rickelmedias/1-DOF-Copter-Control/report/main.tex

% !TEX program = xelatex
% Modelo reduzido TEECII, Manual MSGQ-21.01 REV.16.

\documentclass[
    12pt,                % Tamanho da fonte base (corpo do texto)
    fleqn,               % Equações alinhadas à esquerda, com numeração à direita
    oneside,            % Impressão apenas em recto (frente das páginas)
    a4paper,            % Tamanho do papel: A4 (21.00 cm × 29.70 cm)
    chapter=TITLE,        % Títulos de capítulos convertidos em MAIÚSCULAS
    section=TITLE,        % Títulos de seções convertidos em MAIÚSCULAS  
    sumario=tradicional,% Estilo do sumário (tradicional = indentado)
    english,            % Idioma adicional para hifenização de termos técnicos
    brazil                % Idioma principal do documento (último da lista)
]{abntex2}
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
\titulo{Controle em tempo real de uma plataforma de estabilização ativa por empuxo}
\subtitulo{} 
\integranteum{Gustavo Aguiar Brandão}\raum{210349}
\integrantedois{Lucas Carvalho}\radois{180352}
\integrantetres{Rickelme Dias}\ratres{224276}
\integrantequatro{Guilherme Cambi Magarotti}\raquatro{222292}
\integrantecinco{Guilherme Felipe Reis Soares}\racinco{211590}
\local{SOROCABA, SP}            
\data{2026}                     

\orientador{Prof. Marcos F. Jardini\\Prof. Adilson Rocha}
\coorientador{}                 

\preambulo{Trabalho de Tópicos Especiais em Engenharia da Computação II apresentado ao Centro Universitário Facens como exigência parcial para aprovação na disciplina do curso de graduação em Engenharia da Computação. Documento de Projeto RTOS para a disciplina TEECII.}

\definecolor{blue}{RGB}{41,5,195}  

\makeatletter
\hypersetup{
    pdftitle={\@title},         
    pdfauthor={Gustavo Aguiar Brandão; Lucas Carvalho; Rickelme Dias; Guilherme Cambi Magarotti; Guilherme Felipe Reis Soares},       
    pdfsubject={\imprimirpreambulo}, 
    pdfcreator={LaTeX with abnTeX2}, 
    pdfkeywords={abnt}{latex}{abntex}{abntex2}{trabalho acadêmico}, 
    colorlinks=true,            
    linkcolor=black,            
    citecolor=black,            
    filecolor=black,            
    urlcolor=black,             
    bookmarksdepth=4            
}
\makeatother

\makeatletter
\setlength{\@fptop}{5pt}        
\makeatother

\newcommand{\quadroname}{Quadro}
\newcommand{\listofquadrosname}{Lista de quadros}

\newfloat[chapter]{quadro}{loq}{\quadroname}
\newlistof{listofquadros}{loq}{\listofquadrosname}
\newlistentry{quadro}{loq}{0}

\setfloatadjustment{quadro}{\centering}
\counterwithout{quadro}{chapter}
\renewcommand{\theHquadro}{\arabic{quadro}}

\renewcommand{\cftquadroname}{\MakeUppercase{\quadroname}\space} 
\renewcommand*{\cftquadroaftersnum}{.}

\renewcommand{\cftfigurename}{FIGURA\space}
\renewcommand{\cfttablename}{TABELA\space}
\renewcommand{\cfttableaftersnum}{.}
\renewcommand*{\cftfigureaftersnum}{.}

\setfloatlocations{quadro}{hbtp}

\captionnamefont{\normalfont\normalsize}
\captiontitlefont{\normalfont\normalsize}
\captiondelim{ -- }
\captionstyle{\centering}
\captionsetup{font=normalsize,labelfont=normalfont,textfont=normalfont,justification=centering,singlelinecheck=false,labelsep=endash,position=top,skip=8pt}

\makeatletter
\renewcommand{\fonte}[1]{\par%
  \vspace{2pt} % manual: sem espaço entre o elemento e sua fonte
  {\centering\fontsize{10}{12}\selectfont Fonte: #1\par}%
}
\makeatother

\makeatletter
\settocpreprocessor{chapter}{%
    \let\tempf@rtoc\f@rtoc%     
    \def\f@rtoc{%               
      \texorpdfstring{\MakeTextUppercase{%
        \tempf@rtoc}%           
      }{\tempf@rtoc}%           
    }% 
}
\makeatother

\makeatletter
\let\oldcontentsline\contentsline
\def\contentsline#1#2{%
  \expandafter\ifx\csname l@#1\endcsname\l@section
    \expandafter\@firstoftwo      
  \else
    \expandafter\@secondoftwo     
  \fi
  {%
    \oldcontentsline{#1}{\MakeTextUppercase{#2}}%  
  }{%
    \oldcontentsline{#1}{#2}%     
  }%
}
\makeatother

\cftsetindents{chapter}{0cm}{0.5cm}
\cftsetindents{section}{0cm}{0.8cm}
\cftsetindents{subsection}{0cm}{1.1cm}
\cftsetindents{subsubsection}{0cm}{1.45cm}

\usepackage{float}              

\setlength{\parindent}{1.25cm}  
\setlength{\parskip}{0.0cm}     

\newlist{alineastcc}{enumerate}{1}
\setlist[alineastcc]{
    label=\alph*),
    align=left,
    labelindent=1.88cm,
    labelwidth=0.44cm,
    labelsep=0.20cm,
    leftmargin=2.52cm,
    itemindent=0pt,
    listparindent=0pt,
    itemsep=0pt,
    parsep=0pt,
    topsep=0.5\baselineskip
}

\setlength{\afterchapskip}{\baselineskip}
\setlength{\aftersecskip}{\baselineskip}
\setlength{\aftersubsecskip}{\baselineskip}

\makepagestyle{cabecalhopaginaimpar}
  \makeoddhead{cabecalhopaginaimpar}  
    {}                          
    {}                          
    {\fontsize{10}{12}\selectfont\thepage}            

\begin{document}

\selectlanguage{brazil}
\OnehalfSpacing         
\frenchspacing                  

\hypersetup{pageanchor=false}
\imprimircapa                   
\hypersetup{pageanchor=true}
\pretextual
\imprimirfolhaderosto* 

\input{parts/front_matter/resumo.tex}
\input{parts/front_matter/lista_figuras.tex}
\input{parts/front_matter/lista_tabelas.tex}
\input{parts/front_matter/lista_siglas.tex}
\input{parts/front_matter/lista_simbolos.tex}
\clearpage

\input{parts/front_matter/sumario.tex}

\textual                        
\pagestyle{cabecalhopaginaimpar}
\aliaspagestyle{chapter}{cabecalhopaginaimpar}

\input{parts/body/introducao.tex}
\clearpage
\input{parts/body/referencial_teorico.tex}
\clearpage
\input{parts/body/metodologias.tex}
\clearpage

\input{parts/body/resultados.tex}
\clearpage
\input{parts/body/conclusao.tex}
\clearpage

\makeatletter
\renewcommand{\bibsection}{%
    \cleardoublepage
    \phantomsection
    \Hy@raisedlink{\hyper@anchorstart{referencias.titulo}\hyper@anchorend}%
    \def\@currentHref{referencias.titulo}%
    \addcontentsline{toc}{chapter}{REFERÊNCIAS}
    \begin{flushleft}
        \chaptitlefont\MakeTextUppercase{\bibname}
    \end{flushleft}
    \vspace{\afterchapskip}
}
\makeatother
\begin{SingleSpace}
\RaggedRight
\interlinepenalty=10000
\setlength{\bibitemsep}{\baselineskip}
\bibliography{references}       
\end{SingleSpace}

\end{document}
