rickelmedias/1-DOF-Copter-Control/report/images/photos/power_supply.jpg

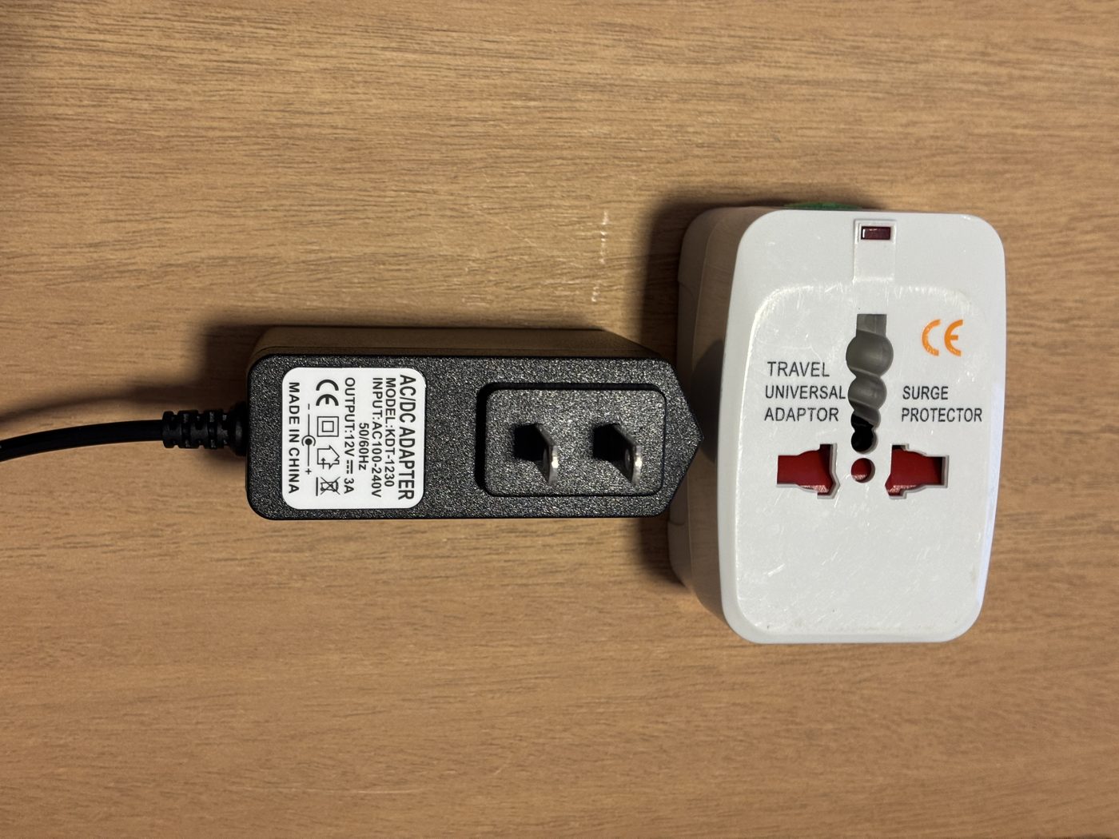
report/images/photos/power_supply.jpg
