rickelmedias/1-DOF-Copter-Control/report/images/prototype/final_rodando.jpg

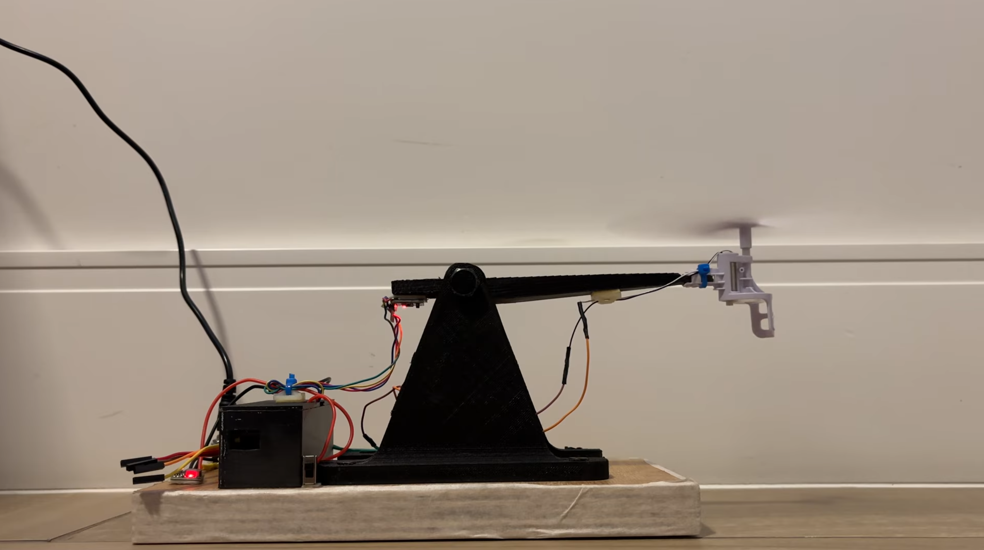
report/images/prototype/final_rodando.jpg
