rickelmedias/1-DOF-Copter-Control/report/parts/front_matter/lista_siglas.tex

\renewcommand{\listadesiglasname}{LISTA DE SIGLAS}
\begin{siglas}
 \item[1-DOF] \textit{One Degree of Freedom} (um grau de liberdade)
 \item[API] \textit{Application Programming Interface}
 \item[BEC] \textit{Battery Eliminator Circuit} (regulador de tensão)
 \item[CMSIS] \textit{Cortex Microcontroller Software Interface Standard}
 \item[DWT] \textit{Data Watchpoint and Trace}
 \item[GPIO] \textit{General-Purpose Input/Output}
 \item[HAL] \textit{Hardware Abstraction Layer}
 \item[I\textsuperscript{2}C] \textit{Inter-Integrated Circuit}
 \item[IAE] \textit{Integral of Absolute Error} (integral do módulo do erro)
 \item[IDE] \textit{Integrated Development Environment}
 \item[IMU] \textit{Inertial Measurement Unit}
 \item[ISR] \textit{Interrupt Service Routine}
 \item[LED] \textit{Light-Emitting Diode}
 \item[MISRA] \textit{Motor Industry Software Reliability Association}
 \item[NVIC] \textit{Nested Vectored Interrupt Controller}
 \item[PID] Proporcional--Integral--Derivativo
 \item[PLL] \textit{Phase-Locked Loop}
 \item[PWM] \textit{Pulse Width Modulation}
 \item[RA] Registro Acadêmico
 \item[RAM] \textit{Random-Access Memory}
 \item[RMS] \textit{Root Mean Square}
 \item[RTOS] \textit{Real-Time Operating System}
 \item[SRAM] \textit{Static Random-Access Memory}
 \item[SWD] \textit{Serial Wire Debug}
 \item[UART] \textit{Universal Asynchronous Receiver-Transmitter}
 \item[USART] \textit{Universal Synchronous/Asynchronous Receiver-Transmitter}
 \item[USB] \textit{Universal Serial Bus}
\end{siglas}
