rickelmedias/1-DOF-Copter-Control/report/parts/front_matter/lista_simbolos.tex

\begin{simbolos}
    \item[$\theta$] Ângulo da haste em relação à horizontal, em graus (radianos nas equações físicas)
    \item[$\hat{\theta}$] Estimativa filtrada do ângulo da haste
    \item[$\dot{\theta}$] Velocidade angular da haste, em graus/s
    \item[$F$] Empuxo produzido pelo conjunto motor--hélice, em N
    \item[$F_{\max}$] Empuxo máximo admitido no modelo, em N
    \item[$u$] Comando PWM normalizado, sem unidade
    \item[$J$] Momento de inércia do conjunto móvel em torno do pivô, em kg m$^2$
    \item[$S_m$] Momento estático das massas em relação ao pivô, em kg m
    \item[$l_m$] Braço do empuxo em relação ao pivô, em m
    \item[$b$] Coeficiente de atrito viscoso da junta, em N m s/rad
    \item[$\tau_m$] Constante de tempo do motor, em s
    \item[$\tau_f$] Constante de tempo do filtro complementar, em s
    \item[$T_s$] Período de amostragem do controle, em s
    \item[$K_p$, $K_i$, $K_d$] Ganhos proporcional, integral e derivativo do controlador PID
    \item[bit/s] Bits por segundo (unidade)
    \item[Hz, kHz, MHz] Hertz, quilohertz e megahertz (unidades)
    \item[kg] Quilograma (unidade)
    \item[ms, $\mu$s] Milissegundo e microssegundo (unidades)
    \item[N] Newton (unidade)
    \item[rad] Radiano (unidade)
    \item[s] Segundo (unidade)
\end{simbolos}
