rickelmedias/1-DOF-Copter-Control/report/parts/front_matter/resumo.tex

\begin{resumo}[RESUMO]
\begin{SingleSpace}
\noindent A malha de atitude de um drone é um sistema de controle crítico, uma vez que atrasos na leitura do sensor, no cálculo ou na atuação podem levar o veículo à queda. Este trabalho reproduz esse problema em uma haste de um grau de liberdade, com motor e hélice em uma extremidade e um sensor inercial na outra, controlada por um microcontrolador STM32F103 com o sistema operacional de tempo real FreeRTOS. A malha de controle é executada em uma tarefa acordada a cada cinco milissegundos por um semáforo liberado pelo temporizador, enquanto os comandos e a telemetria são tratados em tarefas de menor prioridade. Medido no próprio microcontrolador, o atraso entre a interrupção e a atualização do comando do motor foi de no máximo 0,58 milissegundo, pouco mais de um décimo do período, sem nenhum ciclo perdido em quase 35 mil ciclos. Os principais problemas encontrados foram o aquecimento do motor, resolvido com um indutor em série; o ruído do acelerômetro com a hélice em rotação e a deriva do giroscópio, tratados com um filtro complementar que corrige o ângulo lentamente durante o voo; e a oscilação do controlador proporcional-integral-derivativo, tratada com sintonia por margem de fase, proteção contra a saturação do integrador e desligamento do motor por ângulo. Na bancada, a haste pairou com erro quadrático médio inferior a três décimos de grau, e um refino com cinco conjuntos de ganhos reduziu em 28 por cento o erro acumulado na resposta a mudanças de referência.
\par\vspace{2\baselineskip}
\noindent\textbf{Palavras-chave: Controle de posição. Sistemas de tempo real. Modelagem dinâmica. Simulação. Sistemas embarcados.}
\end{SingleSpace}
\end{resumo}
\begin{otherlanguage*}{english}
\begin{resumo}[ABSTRACT]
\begin{SingleSpace}
\noindent The attitude loop of a drone is a safety-critical control system: if sensing, computation or actuation is late, the vehicle falls. This work reproduces that problem on a one-degree-of-freedom rod, with a motor and propeller at one end and an inertial sensor at the other, controlled by an STM32F103 microcontroller running the FreeRTOS real-time operating system. The control loop runs in a task woken every five milliseconds by a semaphore released by the timer, while commands and telemetry run in lower-priority tasks. Measured on the microcontroller itself, the delay from the timer interrupt to the motor command update was at most 0.58 millisecond, slightly more than one tenth of the period, with no lost cycle in almost 35 thousand cycles. The main problems were motor heating, solved with a series inductor; accelerometer noise with the propeller running and gyroscope drift, handled by a complementary filter that corrects the angle slowly in flight; and oscillation of the proportional-integral-derivative controller, handled by phase-margin tuning, protection against integrator saturation and an angle cutoff for the motor. On the bench, the rod hovered with a root-mean-square error below three tenths of a degree, and a refinement with five gain sets reduced the accumulated error in the response to reference changes by 28 percent.
\par\vspace{2\baselineskip}
\noindent\textbf{Keywords: Position control. Real-time systems. Dynamic modeling. Simulation. Embedded systems.}
\end{SingleSpace}
\end{resumo}
\end{otherlanguage*}
