rickelmedias/1-DOF-Copter-Control/report/parts/body/referencial_teorico.tex

\chapter{SISTEMAS CRÍTICOS, RTOS E FREERTOS}\label{cap:rtos}

Este capítulo reúne os fundamentos que sustentam as decisões de projeto. Inicialmente, discute-se por que a malha de estabilização da haste deve ser tratada como um sistema de tempo real; em seguida, apresentam-se os conceitos de sistema operacional de tempo real e os recursos do FreeRTOS empregados no firmware; por fim, resumem-se os fundamentos de estimação de ângulo e de controle PID utilizados nos capítulos seguintes.

\section{POR QUE UM SISTEMA CRÍTICO}

Um sistema de tempo real é aquele cujo comportamento correto depende não apenas do resultado lógico das computações, mas também do instante em que esse resultado é produzido \cite[p.~2]{burns2009}. Segundo \citeonline[p.~2--3]{burns2009}, os sistemas de tempo real classificam-se conforme a consequência da perda de um prazo: nos sistemas \textit{hard}, é absolutamente imperativo que as respostas ocorram dentro do prazo especificado; nos sistemas \textit{soft}, os tempos de resposta são importantes, mas o sistema continua a funcionar corretamente se os prazos forem perdidos ocasionalmente; e um prazo que pode ser perdido ocasionalmente, mas cuja entrega tardia não traz nenhum benefício, é denominado \textit{firm}. Os mesmos autores citam o sistema de controle de voo de uma aeronave de combate como exemplo de sistema \textit{hard}, pois a perda de um prazo pode levar a uma catástrofe \cite[p.~3]{burns2009}.

A malha de atitude de um multirrotor aproxima-se da primeira classe, uma vez que o veículo é instável em malha aberta e uma sequência de atualizações atrasadas permite que o ângulo cresça até a queda. A haste 1-DOF reproduz essa característica. Com o motor desligado, a haste repousa em cerca de $-38^\circ$ (valor lido pelo sensor); nas proximidades da horizontal não há torque restaurador, e a planta comporta-se como um integrador duplo, de modo que o empuxo precisa ser corrigido continuamente. Dois fatos medidos na bancada tornam o prazo concreto: o empuxo responde ao comando com atraso de cerca de 58~ms (Capítulo~\ref{cap:processo}), e a haste acelera cerca de $300^\circ/\mathrm{s}^2$ para cada 1\% de PWM. Assim, uma interrupção do controle por algumas dezenas de milissegundos é suficiente para que a haste percorra uma fração relevante da faixa de operação. O período adotado, de 5~ms, é cerca de doze vezes menor que o atraso do atuador; atrasos sistemáticos nas atualizações reduziriam a margem de fase da malha e a levariam à oscilação.

A política implementada para falhas é deliberadamente simples: uma leitura inválida faz o ciclo ser descartado, mantendo-se a saída anterior; se o sensor permanecer 50~ms sem responder (10 ciclos consecutivos), o motor é desligado. O firmware não descarta amostras por idade; o atraso da malha é tratado na análise temporal (Seção~\ref{sec:temporal}). Segundo a classificação anterior, o enquadramento do sistema como \textit{hard} ou \textit{firm} depende do efeito da perda de um prazo. Neste protótipo, o pior caso é a queda da haste, sem risco para pessoas; por esse motivo, o prazo é tratado como crítico para o desempenho, e não para a segurança.

Controladores de voo reais seguem a mesma lógica. \citeonline[p.~134870]{rico2022} propõem um controlador de voo para aplicações profissionais executado sobre um RTOS simplificado, com escalonador híbrido que combina ordem de chegada (\textit{first-come-first-serve}) e prazo mais próximo primeiro (\textit{earliest deadline first}) com prioridade dinâmica; o sistema é avaliado por testes de escalonabilidade para monoprocessadores e por dados reais de voo, e os sensores redundantes ficam em uma unidade isolada das vibrações da estrutura. O presente trabalho, por sua vez, emprega o escalonamento preemptivo por prioridades fixas do FreeRTOS, suficiente para uma malha crítica e duas tarefas de apoio.

\section{SISTEMAS OPERACIONAIS DE TEMPO REAL}

Um sistema operacional organiza a execução dos programas e o acesso aos recursos do processador. Em um sistema embarcado, cada tarefa é um trecho de código executado como se dispusesse do processador de forma exclusiva; o escalonador decide qual tarefa executa a cada instante, e as interrupções sinalizam eventos externos ao processador. No escalonamento preemptivo por prioridades fixas, adotado pelo FreeRTOS, a tarefa pronta de maior prioridade sempre ocupa o processador e interrompe imediatamente uma tarefa de prioridade inferior \cite{barry2016}. Essa política, por si só, não garante o cumprimento dos prazos: a previsibilidade depende da análise conjunta dos tempos de execução, dos períodos, das prioridades e dos bloqueios da aplicação \cite[p.~369--375]{burns2009}.

\section{O FREERTOS}

O FreeRTOS é um núcleo de código aberto para microcontroladores que oferece tarefas, filas, semáforos, \textit{mutexes}, temporizadores de software e gerenciamento de memória \cite{freertosmanual,barry2016}. Os conceitos empregados neste trabalho são os seguintes:

\begin{alineastcc}
 \item \textbf{Tarefas e prioridades:} cada tarefa é uma função com laço infinito e pilha própria; quanto maior o número, maior a prioridade;
 \item \textbf{Semáforo binário:} sinaliza a ocorrência de um evento. A interrupção do temporizador libera o semáforo, e a tarefa de controle, bloqueada à espera dele, é acordada, técnica denominada processamento diferido da interrupção \cite{barry2016};
 \item \textbf{Fila:} transfere cópias de dados entre uma interrupção ou tarefa produtora e uma tarefa consumidora; neste trabalho, transporta os bytes recebidos pela serial;
 \item \textbf{\textit{Mutex} com herança de prioridade:} garante exclusão mútua no acesso a dados compartilhados. Quando uma tarefa de maior prioridade aguarda o \textit{mutex}, a tarefa que o detém herda temporariamente essa prioridade, o que reduz, mas não elimina, os efeitos da inversão de prioridade \cite{barry2016}, uma vez que o bloqueio continua a existir e precisa ser considerado na análise de escalonabilidade \cite[p.~384--385]{burns2009};
 \item \textbf{Funções \texttt{FromISR}:} são as únicas funções da API permitidas dentro de rotinas de interrupção. No Cortex-M3, as interrupções que as chamam devem ter prioridade lógica igual ou inferior ao limite \texttt{configMAX\_SYSCALL\_INTERRUPT\_PRIORITY}, o que corresponde a um valor numérico igual ou maior, pois no NVIC números menores representam prioridades mais altas \cite{freertoscortex}.
\end{alineastcc}

O STM32F103 emprega um núcleo Arm Cortex-M3 de até 72~MHz, sem unidade de ponto flutuante, com 20~kB de SRAM e 64~kB de Flash na versão C8 \cite{stm32f103ds}; a placa utilizada, entretanto, reporta 128~kB de Flash. Como não há unidade de ponto flutuante, as operações com \texttt{float} são emuladas em software e pesam no tempo de execução.

\section{FUNDAMENTOS DE CONTROLE E ESTIMAÇÃO}

\subsection{Estimação do ângulo: acelerômetro, giroscópio e filtro complementar}

Na ausência de aceleração linear, a saída de um acelerômetro de três eixos corresponde apenas ao vetor da gravidade rotacionado e permite calcular a inclinação do sensor. Para uma rotação em torno do eixo Y, o ângulo de arfagem é dado por $\theta=\tan^{-1}\left(-G_x/G_z\right)$, calculado com a função \texttt{atan2} para preservar o quadrante \cite{nxpan3461}. \citeonline{nxpan3461} ressalta, porém, que essa hipótese é necessária para a solução e que qualquer aceleração linear introduz erro na estimativa de orientação, limitação também discutida na estimação de atitude de veículos aéreos \cite[p.~147--149]{beard2012} e de multirrotores \cite[p.~149]{quan2017}; é o que ocorre com a vibração da hélice (Seção~\ref{sec:ruido}). O giroscópio, por sua vez, mede a velocidade angular e, integrado, fornece um ângulo suave, porém sujeito a deriva em razão do viés do sensor. \citeonline{colton2007} descreve essa deriva como o efeito de uma pequena taxa residual que, quando o giroscópio parado não lê exatamente zero, continua a ser somada ao ângulo até afastá-lo do valor real \cite[p.~9--10]{colton2007}. O filtro complementar combina as duas medidas: o giroscópio predomina no curto prazo e o acelerômetro corrige a deriva no longo prazo \cite[p.~14]{colton2007}. Na forma discreta,
\begin{equation}
 \hat\theta[k]=\alpha\left(\hat\theta[k-1]+T_s\,\omega_g[k]\right)+(1-\alpha)\,\theta_a[k],\qquad \alpha=\frac{\tau_f}{\tau_f+T_s}
 \label{eq:complementar}
\end{equation}
em que $\hat\theta$ é o ângulo estimado, $\omega_g$ a velocidade angular medida pelo giroscópio, $\theta_a$ o ângulo calculado pelo acelerômetro, $T_s$ o período de amostragem e $\tau_f$ a constante de tempo do filtro. Para escalas de tempo menores que $\tau_f$, prevalece o giroscópio; para escalas maiores, o acelerômetro \cite[p.~13--14]{colton2007}. Trata-se de um filtro de primeira ordem, de custo computacional desprezível no Cortex-M3 e com um único parâmetro de ajuste. No firmware, a constante de tempo depende do estado do motor: com o motor desligado, o acelerômetro corrige o ângulo em poucos segundos; com o motor ligado, a correção é lenta, da ordem de 30~s, porque a vibração da hélice degrada a leitura (Seções~\ref{sec:ruido} e~\ref{sec:deriva}).

\subsection{PID discreto, derivada na medida e anti-\textit{windup}}

O controlador PID combina uma parcela proporcional ao erro, uma parcela proporcional à sua integral e uma parcela derivativa \cite[p.~64]{astrom1995}. Na forma discreta, com período $T_s$ e erro $e=\theta_r-\hat\theta$, a lei de controle empregada é
\begin{equation}
 u[k]=K_p\,e[k]+I[k]-K_d\,\dot{\hat\theta}[k],\qquad I[k]=I[k-1]+K_i\,e[k]\,T_s
 \label{eq:pid}
\end{equation}
em que $u$ é a saída em porcentagem de PWM, $I$ o estado do integrador, $\dot{\hat\theta}$ a velocidade angular medida pelo giroscópio, filtrada por um passa-baixas de primeira ordem com constante de tempo de 5~ms, e $K_p$, $K_i$ e $K_d$ os ganhos proporcional, integral e derivativo. A saída é limitada à faixa de 10\% a 32\%, e o estado do integrador, à faixa de 0 a 32\%. A parcela derivativa atua sobre a medida (neste caso, a velocidade fornecida pelo giroscópio) e não sobre o erro, o que corresponde ao peso $c=0$ na ponderação da referência e evita grandes transitórios no sinal de controle quando a referência varia bruscamente \cite[p.~73--74]{astrom1995}.

O atuador, contudo, possui limites: o PWM varia entre zero e um valor máximo, e a hélice produz empuxo em apenas um sentido. Quando a saída satura, o integrador continua a acumular o erro e, quando o sistema retorna à faixa linear, a saída permanece presa ao limite até que o integrador seja descarregado. Esse fenômeno é denominado \textit{integrator windup} \cite[p.~1693]{astrom1989}. \citeonline[p.~1695]{astrom1989} apresentam dois métodos \textit{ad hoc} para evitá-lo, o rastreamento (\textit{back-calculation}) e a integração condicional, que podem ser combinados, além de uma abordagem geral baseada em observador. No rastreamento, quando a saída satura, o integrador é recalculado de modo que a saída permaneça no limite de saturação, preferencialmente de forma dinâmica, com uma constante de tempo de rastreamento \cite[p.~83--84]{astrom1995}; \citeonline[p.~307]{astrom2008} descrevem a mesma ideia como um caminho de realimentação adicional, de ganho $k_t$, entre o erro de saturação e a entrada do integrador. Na integração condicional, também chamada de \textit{integrator clamping}, a integração é desligada quando o controle está longe do regime permanente \cite[p.~88--89]{astrom1995}; na implementação deste trabalho, ela é suspensa enquanto a saída está saturada e o erro tende a aprofundar a saturação. Uma alternativa ainda mais simples consiste em apenas limitar o valor do estado do integrador. O firmware emprega a integração condicional, e o Capítulo~\ref{cap:processo} compara as alternativas por meio de simulação.
