rickelmedias/1-DOF-Copter-Control/report/parts/back_matter/anexos.tex

\begin{anexosenv}

    \newpage
    \phantomsection
    
    \addcontentsline{toc}{chapter}{ANEXOS}
    \addtocontents{toc}{\protect\setcounter{tocdepth}{-1}}
    
    % coloca o primeiro anexo na mesma pagina do titulo do capitulo
    \chapter{Morbi ultrices rutrum lorem}
    \lipsum[30]

    \chapter{Cras non urna sed feugiat cum sociis natoque penatibus et magnis dis
    parturient montes nascetur ridiculus mus}
    \lipsum[31]

    \chapter{Fusce facilisis lacinia dui}
    \lipsum[32]
    
    \addtocontents{toc}{\protect\setcounter{tocdepth}{0}}
\end{anexosenv}
