rickelmedias/1-DOF-Copter-Control/report/parts/back_matter/apendices.tex

\begin{apendicesenv}

    \newpage
    \phantomsection
    
    \addcontentsline{toc}{chapter}{APÊNDICES}
    \addtocontents{toc}{\protect\setcounter{tocdepth}{-1}}
    
    \chapter{Quisque libero justo}
    \lipsum[50]

    \chapter{Nullam elementum urna vel imperdiet sodales elit ipsum pharetra ligula
    ac pretium ante justo a nulla curabitur tristique arcu eu metus}
    \lipsum[55-57]
    
    \addtocontents{toc}{\protect\setcounter{tocdepth}{0}}
\end{apendicesenv}
