rickelmedias/1-DOF-Copter-Control/report/parts/front_matter/dedicatoria.tex

% ============================================================================
% DEDICATÓRIA (Opcional)
% FONTE: Manual Facens MSGQ-21.01 REV.18
%
% REGRAS:
% - NÃO escrever a palavra "DEDICATÓRIA" na página
% - Fonte Arial 12pt, espaçamento 1,5, alinhado à DIREITA
% - Texto no final da página
% - Recomendável uma única dedicatória por trabalho
%   (se for em grupo e cada membro quiser a sua, uma por página)
% ============================================================================

\begin{dedicatoria}
    \vspace*{\fill} % Empurra o texto para o final da página

    \begin{flushright}
        \begin{minipage}{10cm}
            \begin{OnehalfSpace}
                % ============================================================
                % SUBSTITUA pelo seu texto de dedicatória.
                % Exemplos:
                %
                % Dedico este trabalho à minha família,
                % pelo apoio incondicional em cada etapa desta jornada.
                %
                % Aos meus pais, que tornaram este momento possível.
                % ============================================================
                Dedico este trabalho à minha família,\\
                pelo apoio incondicional em cada etapa desta jornada.
            \end{OnehalfSpace}
        \end{minipage}
    \end{flushright}
\end{dedicatoria}
