rickelmedias/1-DOF-Copter-Control/report/parts/front_matter/ficha_catalografica.tex

\begin{fichacatalografica}
    % =========================================================
    % SUBSTITUA pelo PDF gerado pela biblioteca Facens
    % Solicitação: biblioteca@facens.br ou
    % https://forms.office.com/r/Jhzq46KFHz (prazo: 48h úteis)
    % =========================================================
    \includepdf[pages=1]{samples/FICHA_CATALOGRAFICA_modelo_graduacao_ou_pos_ate_3_autores.pdf}
\end{fichacatalografica}
