rickelmedias/1-DOF-Copter-Control/report/parts/front_matter/folha_aprovacao.tex

\begin{folhadeaprovacao}
    % =========================================================
    % SUBSTITUA pelo PDF digitalizado após recolher as
    % assinaturas dos avaliadores da banca examinadora.
    % O formulário em branco (FSGQ-21.02.02) está disponível
    % na coordenadoria do seu curso.
    % =========================================================
    \includepdf[pages=1]{samples/FSGQ_21_02_02_FOLHA_DE_APROV_ALUNO_PEDE_ASSINATURAS.pdf}
\end{folhadeaprovacao}
