rickelmedias/1-DOF-Copter-Control/report/parts/front_matter/lista_abreviaturas.tex

\renewcommand{\listadesiglasname}{LISTA DE ABREVIATURAS}
\begin{siglas}
 \item[bit/s] bits por segundo
 \item[Hz] hertz
 \item[kg] quilograma
 \item[kHz] quilohertz
 \item[ms] milissegundo
 \item[$\mu$s] microssegundo
 \item[N] newton
 \item[rad] radiano
 \item[s] segundo
\end{siglas}
