rickelmedias/1-DOF-Copter-Control/report/images/results/histogramas_tempo.pdf

0 | 200 | 400 | 600 | 800 | 1000
Latência interrupção → PWM (µs)

10

2

10

3

10

4

Ciclos

4995 | 5000 | 5005 | 5010
Intervalo entre interrupções (µs)

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
