rickelmedias/1-DOF-Copter-Control/report/images/results/refino_metricas.pdf

T1 | T2 | T3 | T4 | T5

0.00

0.05

0.10

0.15

0.20

0.25

0.30

RMS do erro (°)

T1 | T2 | T3 | T4 | T5

0.0

0.5

1.0

1.5

2.0

Pico a pico (°)

T1 | T2 | T3 | T4 | T5

0.00

0.02

0.04

0.06

0.08

0.10

0.12

0.14

Atividade da saída (% por amostra)
