rickelmedias/1-DOF-Copter-Control/report/images/results/partida.pdf

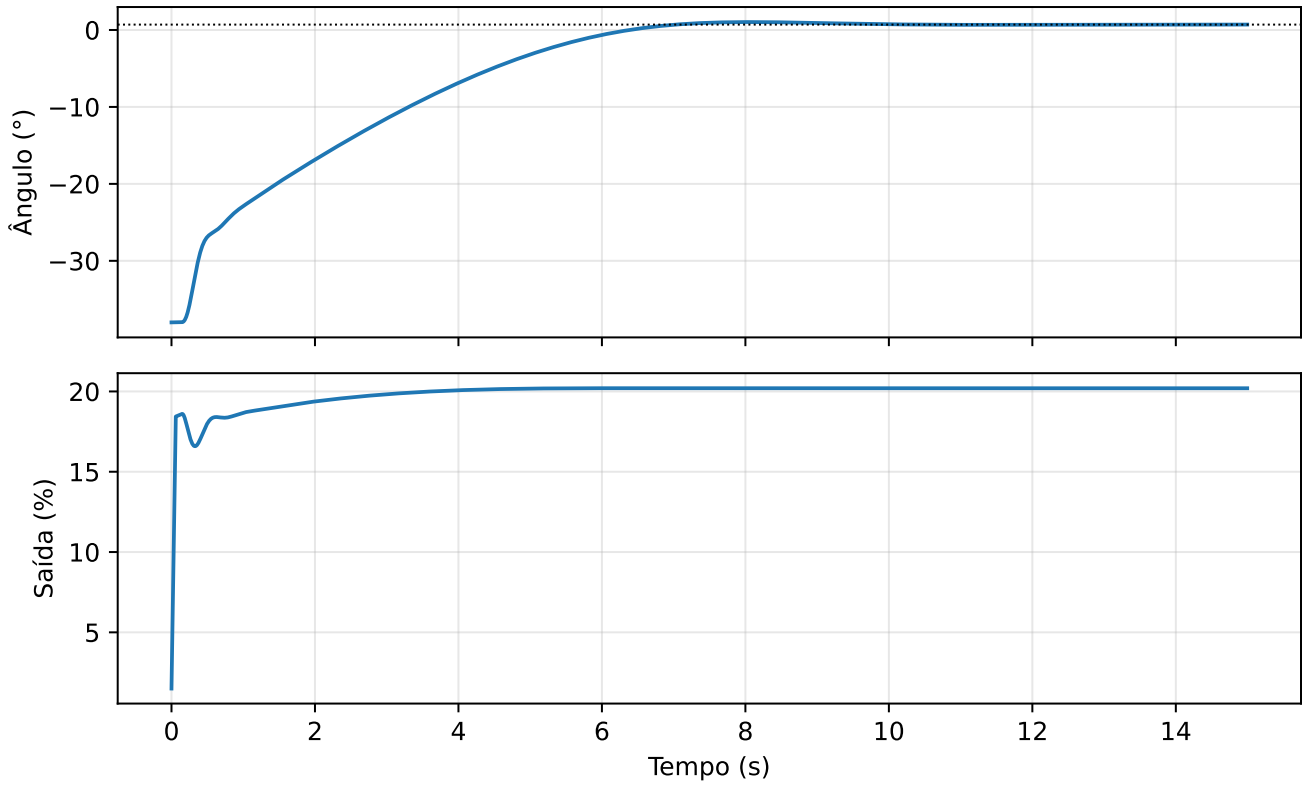
[picture p21: figure]
Ângulo (°); Tempo (s); Saída (%)
