rickelmedias/1-DOF-Copter-Control/report/images/results/partida_real_vs_sim.pdf

−30 −20 −100

### Ângulo (°)

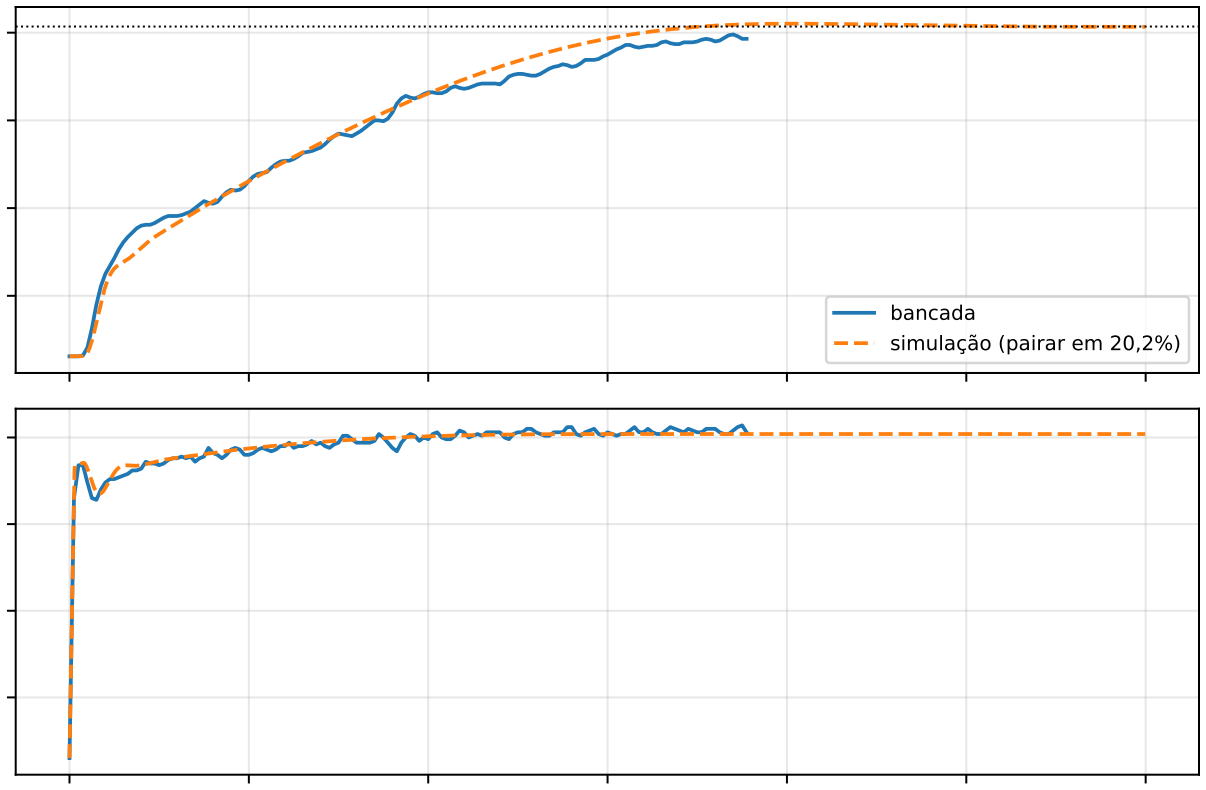
[picture p22: figure]
bancada simulação (pairar em 20,2%)

0

2

4

6

8 | 10 | 12

### Tempo (s)

5

10

15

20

### Saída (%)
