rickelmedias/1-DOF-Copter-Control/report/images/results/refino_degraus_metricas.pdf

T1 | T2 | T3 | T4 | T5

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
IAE total (° s, 3 janelas)

T1 | T2 | T3 | T4 | T5

02468

10

12

Sobressinal médio (%)

T1 | T2 | T3 | T4 | T5

012345

Tempo até 90% médio (s)
