rickelmedias/1-DOF-Copter-Control/report/images/results/refino_histograma.pdf

−0.5 | 0.0 | 0.5 | 1.0 | 1.5
| | Ângulo (°)

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
## Amostras

T1 atual 0,06/0,05/0,04 T2 sem anti-windup T3 Ki 0,08

| T4 Kp 0,08 Ki 0,08 T5 Ki 0,09
