rickelmedias/1-DOF-Copter-Control/data/tests/T1_atual.csv

indice | t_s | angulo_graus | velocidade_dps | ang_acel_graus | acel_g | saida_pct | kp | ki | kd | aw
400 | 0.0 | 0.3 | 2.2 | 0.3 | 0.95 | 19.6 | 0.06 | 0.05 | 0.04 | 1
401 | 0.05 | 0.6 | 9.4 | -3.3 | 1.2 | 19.3 | 0.06 | 0.05 | 0.04 | 1
402 | 0.1 | 0.9 | 2.1 | -2.8 | 0.91 | 19.4 | 0.06 | 0.05 | 0.04 | 1
403 | 0.15 | 0.9 | 0.3 | 14.2 | 0.85 | 19.6 | 0.06 | 0.05 | 0.04 | 1
404 | 0.2 | 0.9 | -4.6 | 25.1 | 0.68 | 19.7 | 0.06 | 0.05 | 0.04 | 1
405 | 0.25 | 0.7 | -2.2 | 7.4 | 0.82 | 19.7 | 0.06 | 0.05 | 0.04 | 1
406 | 0.3 | 0.6 | -0.1 | 7.2 | 1.09 | 19.6 | 0.06 | 0.05 | 0.04 | 1
407 | 0.35 | 0.8 | 4.8 | -5.9 | 1.49 | 19.4 | 0.06 | 0.05 | 0.04 | 1
408 | 0.4 | 0.9 | 4.9 | -4.8 | 1.07 | 19.4 | 0.06 | 0.05 | 0.04 | 1
409 | 0.45 | 0.9 | -4.0 | 0.2 | 0.92 | 19.6 | 0.06 | 0.05 | 0.04 | 1
410 | 0.5 | 0.7 | -0.9 | 13.0 | 0.96 | 19.7 | 0.06 | 0.05 | 0.04 | 1
411 | 0.55 | 0.8 | -0.2 | 8.4 | 0.72 | 19.5 | 0.06 | 0.05 | 0.04 | 1
412 | 0.6 | 1.0 | 6.7 | 1.0 | 1.04 | 19.3 | 0.06 | 0.05 | 0.04 | 1
413 | 0.65 | 1.2 | 2.7 | -4.2 | 1.22 | 19.4 | 0.06 | 0.05 | 0.04 | 1
414 | 0.7 | 1.5 | 6.5 | 4.2 | 1.01 | 19.3 | 0.06 | 0.05 | 0.04 | 1
415 | 0.75 | 1.4 | -6.2 | -2.5 | 1.1 | 19.7 | 0.06 | 0.05 | 0.04 | 1
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
