rickelmedias/1-DOF-Copter-Control/data/tests/T2_aw_desligado.csv

indice | t_s | angulo_graus | velocidade_dps | ang_acel_graus | acel_g | saida_pct | kp | ki | kd | aw
400 | 0.0 | 0.5 | -4.0 | 6.5 | 0.77 | 20.1 | 0.06 | 0.05 | 0.04 | 0
401 | 0.05 | 0.5 | -0.8 | 0.9 | 0.85 | 19.9 | 0.06 | 0.05 | 0.04 | 0
402 | 0.1 | 0.6 | 5.6 | 5.4 | 1.06 | 19.8 | 0.06 | 0.05 | 0.04 | 0
403 | 0.15 | 0.7 | -1.0 | 5.3 | 0.91 | 19.9 | 0.06 | 0.05 | 0.04 | 0
404 | 0.2 | 0.7 | -2.1 | 8.6 | 0.66 | 20.0 | 0.06 | 0.05 | 0.04 | 0
405 | 0.25 | 0.7 | 2.7 | 3.3 | 1.04 | 19.9 | 0.06 | 0.05 | 0.04 | 0
406 | 0.3 | 0.6 | -5.5 | -5.3 | 0.98 | 20.1 | 0.06 | 0.05 | 0.04 | 0
407 | 0.35 | 0.6 | 1.7 | 4.2 | 0.68 | 19.9 | 0.06 | 0.05 | 0.04 | 0
408 | 0.4 | 0.7 | 7.8 | 2.5 | 1.24 | 19.7 | 0.06 | 0.05 | 0.04 | 0
409 | 0.45 | 1.0 | 3.1 | -3.1 | 0.94 | 19.7 | 0.06 | 0.05 | 0.04 | 0
410 | 0.5 | 1.1 | 1.8 | 13.8 | 0.88 | 19.9 | 0.06 | 0.05 | 0.04 | 0
411 | 0.55 | 1.0 | -8.9 | 11.4 | 0.84 | 20.2 | 0.06 | 0.05 | 0.04 | 0
412 | 0.6 | 0.6 | -7.3 | -1.3 | 1.05 | 20.3 | 0.06 | 0.05 | 0.04 | 0
413 | 0.65 | 0.0 | -11.1 | -19.1 | 0.9 | 20.4 | 0.06 | 0.05 | 0.04 | 0
414 | 0.7 | 0.0 | 4.7 | -10.3 | 1.07 | 19.8 | 0.06 | 0.05 | 0.04 | 0
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
