rickelmedias/1-DOF-Copter-Control/data/tests/T3_ki008.csv

indice | t_s | angulo_graus | velocidade_dps | ang_acel_graus | acel_g | saida_pct | kp | ki | kd | aw
400 | 0.0 | 1.2 | 3.4 | -7.5 | 1.16 | 19.9 | 0.06 | 0.08 | 0.04 | 1
401 | 0.05 | 1.1 | -0.7 | -5.4 | 1.05 | 20.1 | 0.06 | 0.08 | 0.04 | 1
402 | 0.1 | 0.8 | -12.1 | 13.1 | 0.67 | 20.4 | 0.06 | 0.08 | 0.04 | 1
403 | 0.15 | 0.4 | -3.3 | 2.3 | 1.1 | 20.3 | 0.06 | 0.08 | 0.04 | 1
404 | 0.2 | 0.3 | 1.6 | 37.4 | 0.57 | 20.1 | 0.06 | 0.08 | 0.04 | 1
405 | 0.25 | 0.6 | 6.2 | 2.2 | 0.92 | 19.8 | 0.06 | 0.08 | 0.04 | 1
406 | 0.3 | 0.8 | 3.8 | 1.8 | 0.9 | 19.9 | 0.06 | 0.08 | 0.04 | 1
407 | 0.35 | 0.9 | -5.1 | 10.1 | 0.71 | 20.2 | 0.06 | 0.08 | 0.04 | 1
408 | 0.4 | 0.6 | -1.7 | 2.1 | 1.07 | 20.2 | 0.06 | 0.08 | 0.04 | 1
409 | 0.45 | 0.4 | -2.0 | 17.3 | 0.79 | 20.2 | 0.06 | 0.08 | 0.04 | 1
410 | 0.5 | 0.4 | -0.6 | 5.1 | 1.08 | 20.1 | 0.06 | 0.08 | 0.04 | 1
411 | 0.55 | 0.6 | 8.5 | 0.5 | 0.99 | 19.8 | 0.06 | 0.08 | 0.04 | 1
412 | 0.6 | 0.9 | 3.8 | -2.4 | 0.93 | 19.9 | 0.06 | 0.08 | 0.04 | 1
413 | 0.65 | 1.2 | 4.0 | -5.3 | 1.34 | 19.8 | 0.06 | 0.08 | 0.04 | 1
414 | 0.7 | 1.3 | 4.9 | -7.4 | 1.03 | 19.9 | 0.06 | 0.08 | 0.04 | 1
415 | 0.75 | 1.2 | -10.9 | 4.8 | 1.08 | 20.3 | 0.06 | 0.08 | 0.04 | 1
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
