rickelmedias/1-DOF-Copter-Control/data/tests/T4_kp008_ki008.csv

indice | t_s | angulo_graus | velocidade_dps | ang_acel_graus | acel_g | saida_pct | kp | ki | kd | aw
400 | 0.0 | 1.0 | -1.8 | -8.3 | 0.92 | 19.7 | 0.08 | 0.08 | 0.04 | 1
401 | 0.05 | 0.7 | -10.5 | 4.4 | 0.95 | 19.9 | 0.08 | 0.08 | 0.04 | 1
402 | 0.1 | 0.4 | -2.8 | 14.4 | 0.96 | 19.8 | 0.08 | 0.08 | 0.04 | 1
403 | 0.15 | 0.3 | -2.7 | -0.1 | 0.95 | 19.7 | 0.08 | 0.08 | 0.04 | 1
404 | 0.2 | 0.4 | 6.0 | 2.2 | 1.11 | 19.5 | 0.08 | 0.08 | 0.04 | 1
405 | 0.25 | 0.6 | 2.4 | 0.0 | 1.15 | 19.4 | 0.08 | 0.08 | 0.04 | 1
406 | 0.3 | 0.7 | 2.0 | 3.1 | 0.89 | 19.6 | 0.08 | 0.08 | 0.04 | 1
407 | 0.35 | 0.5 | -5.8 | 14.8 | 0.75 | 19.8 | 0.08 | 0.08 | 0.04 | 1
408 | 0.4 | 0.3 | -2.2 | 4.0 | 1.05 | 19.7 | 0.08 | 0.08 | 0.04 | 1
409 | 0.45 | 0.2 | 0.7 | 6.1 | 1.01 | 19.6 | 0.08 | 0.08 | 0.04 | 1
410 | 0.5 | 0.4 | 6.4 | -14.4 | 1.25 | 19.4 | 0.08 | 0.08 | 0.04 | 1
411 | 0.55 | 0.8 | 8.7 | -0.6 | 0.82 | 19.3 | 0.08 | 0.08 | 0.04 | 1
412 | 0.6 | 1.1 | 1.8 | 1.5 | 0.89 | 19.4 | 0.08 | 0.08 | 0.04 | 1
413 | 0.65 | 1.3 | 1.3 | 15.2 | 0.98 | 19.5 | 0.08 | 0.08 | 0.04 | 1
414 | 0.7 | 1.2 | -8.2 | 6.9 | 0.8 | 19.8 | 0.08 | 0.08 | 0.04 | 1
415 | 0.75 | 0.9 | -3.2 | -0.9 | 1.07 | 19.8 | 0.08 | 0.08 | 0.04 | 1
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
