rickelmedias/1-DOF-Copter-Control/data/tests/T5_ki009.csv

indice | t_s | angulo_graus | velocidade_dps | ang_acel_graus | acel_g | saida_pct | kp | ki | kd | aw
400 | 0.0 | 0.4 | 4.4 | -2.8 | 0.95 | 19.7 | 0.06 | 0.09 | 0.04 | 1
401 | 0.05 | 0.6 | 0.9 | 4.2 | 0.86 | 19.9 | 0.06 | 0.09 | 0.04 | 1
402 | 0.1 | 0.4 | -6.0 | 1.2 | 0.75 | 20.1 | 0.06 | 0.09 | 0.04 | 1
403 | 0.15 | 0.4 | 3.7 | -0.9 | 1.1 | 19.8 | 0.06 | 0.09 | 0.04 | 1
404 | 0.2 | 0.5 | 0.0 | 0.0 | 0.76 | 19.9 | 0.06 | 0.09 | 0.04 | 1
405 | 0.25 | 0.6 | -0.5 | 0.3 | 0.84 | 19.9 | 0.06 | 0.09 | 0.04 | 1
406 | 0.3 | 0.4 | -2.4 | -4.2 | 1.14 | 20.1 | 0.06 | 0.09 | 0.04 | 1
407 | 0.35 | 0.3 | -2.0 | 7.2 | 0.82 | 19.9 | 0.06 | 0.09 | 0.04 | 1
408 | 0.4 | 0.6 | 8.4 | 17.0 | 0.85 | 19.6 | 0.06 | 0.09 | 0.04 | 1
409 | 0.45 | 0.9 | 2.6 | -2.1 | 1.25 | 19.7 | 0.06 | 0.09 | 0.04 | 1
410 | 0.5 | 1.0 | 1.2 | 1.2 | 1.0 | 19.9 | 0.06 | 0.09 | 0.04 | 1
411 | 0.55 | 0.7 | -7.9 | 1.5 | 1.06 | 20.2 | 0.06 | 0.09 | 0.04 | 1
412 | 0.6 | 0.4 | -3.6 | -10.0 | 1.35 | 20.1 | 0.06 | 0.09 | 0.04 | 1
413 | 0.65 | 0.4 | 5.2 | -5.2 | 1.07 | 19.8 | 0.06 | 0.09 | 0.04 | 1
414 | 0.7 | 0.6 | -2.5 | 4.8 | 0.94 | 19.9 | 0.06 | 0.09 | 0.04 | 1
415 | 0.75 | 0.6 | 0.6 | 5.2 | 1.12 | 19.9 | 0.06 | 0.09 | 0.04 | 1
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
