rickelmedias/1-DOF-Copter-Control/data/tests/metricas.csv

teste | kp | ki | kd | aw | N | media | desvio | rms_erro | max_abs_erro | pico_a_pico | saida_media | saida_desvio | atividade | vel_rms
T1_atual | 0.06 | 0.05 | 0.04 | 1 | 1200 | 0.707 | 0.301 | 0.301 | 1.000 | 1.800 | 19.497 | 0.1772 | 0.1445 | 4.596
T2_aw_desligado | 0.06 | 0.05 | 0.04 | 0 | 1200 | 0.600 | 0.298 | 0.314 | 1.100 | 1.800 | 20.037 | 0.1674 | 0.1404 | 4.391
T3_ki008 | 0.06 | 0.08 | 0.04 | 1 | 1200 | 0.654 | 0.313 | 0.317 | 1.100 | 2.000 | 20.080 | 0.1759 | 0.1449 | 4.611
T4_kp008_ki008 | 0.08 | 0.08 | 0.04 | 1 | 1200 | 0.589 | 0.280 | 0.301 | 0.900 | 1.700 | 19.716 | 0.1835 | 0.1431 | 4.567
T5_ki009 | 0.06 | 0.09 | 0.04 | 1 | 1200 | 0.621 | 0.284 | 0.294 | 1.000 | 1.800 | 20.001 | 0.1714 | 0.1421 | 4.635
