rickelmedias/1-DOF-Copter-Control/report/images/hardware/esquema_ligacoes.pdf

Fonte 12 V | BEC 12 → 5 V | Chave

# Blue Pill

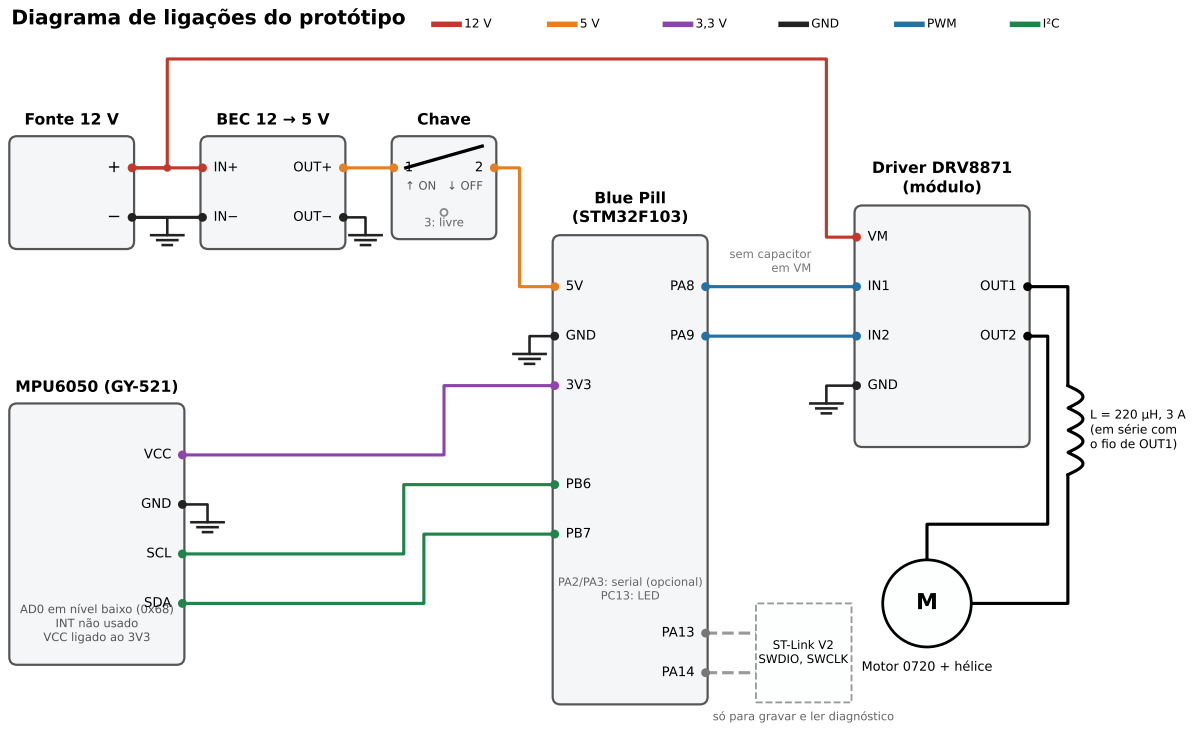
[picture p23: page 1]
3: livre; ↑ ON ↓ OFF; (STM32F103); PA2/PA3: serial (opcional) PC13: LED; MPU6050 (GY-521); Driver DRV8871 (módulo); sem capacitor em VM; Motor 0720 + hélice; ST-Link V2 SWDIO, SWCLK; Diagrama de ligações do protótipo; GND; PWM; I²C; OUT+; OUT−; VCC; SCL; SDA; OUT1; OUT2

(em série com
o fio de OUT1)

AD0 em nível baixo (0x68)

INT não usado
VCC ligado ao 3V3

só para gravar e ler diagnóstico
