rickelmedias/1-DOF-Copter-Control/report/images/results/filtro_pairando.pdf

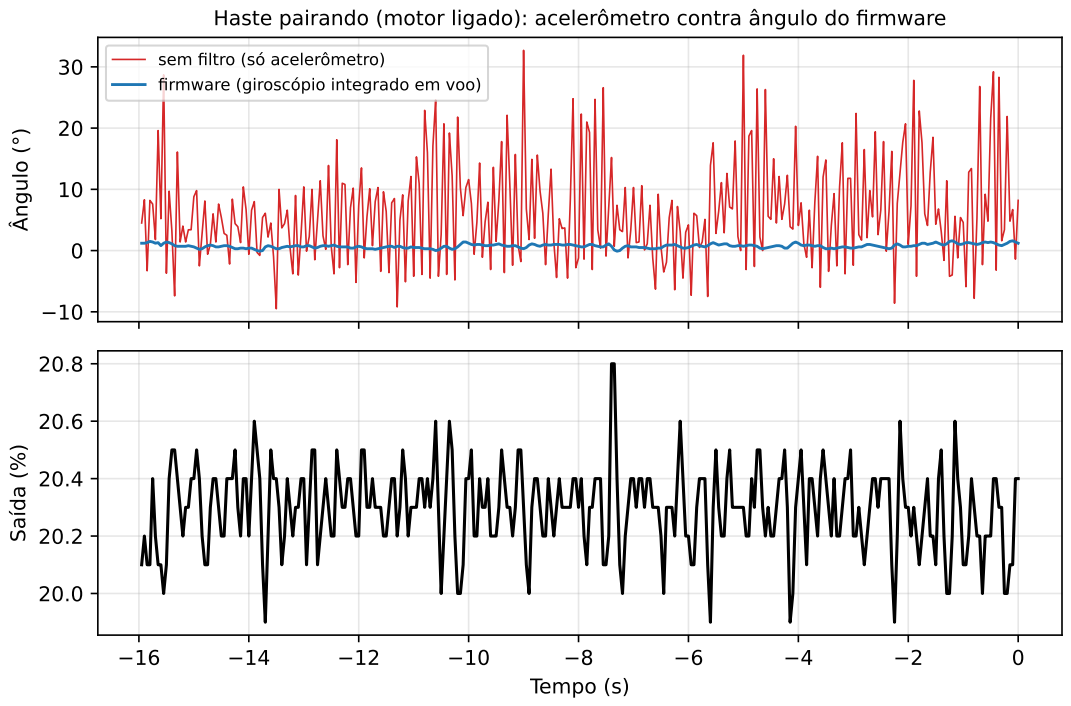
[picture p24: page 1]
Ângulo (°); Tempo (s); Saída (%)

Haste pairando (motor ligado): acelerômetro contra ângulo do firmware

sem filtro (só acelerômetro)
firmware (giroscópio integrado em voo)
