rickelmedias/1-DOF-Copter-Control/report/images/results/refino_paineis.pdf

0

1

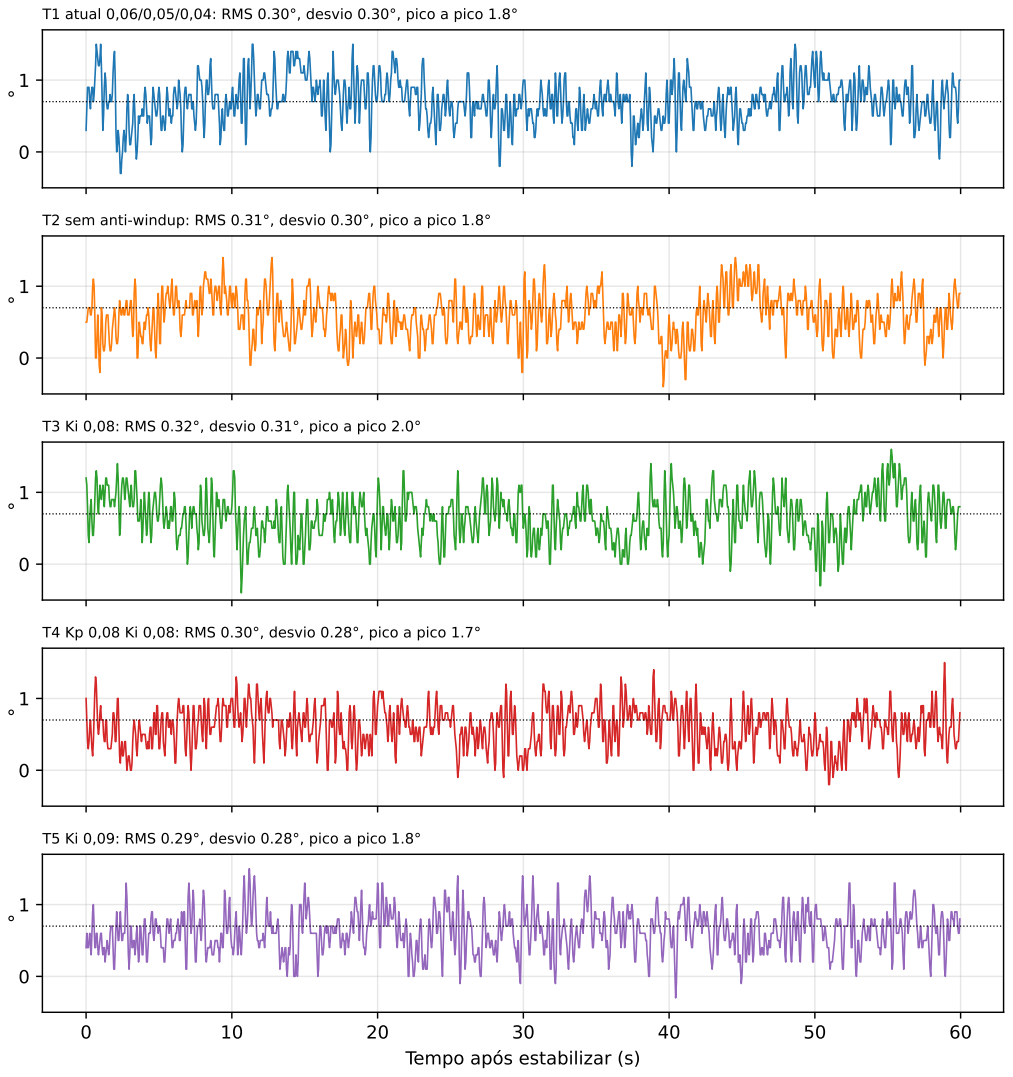
[picture p25: page 1]

T1 atual 0,06/0,05/0,04: RMS 0.30°, desvio 0.30°, pico a pico 1.8°

T2 sem anti-windup: RMS 0.31°, desvio 0.30°, pico a pico 1.8°

T3 Ki 0,08: RMS 0.32°, desvio 0.31°, pico a pico 2.0°

T4 Kp 0,08 Ki 0,08: RMS 0.30°, desvio 0.28°, pico a pico 1.7°

T5 Ki 0,09: RMS 0.29°, desvio 0.28°, pico a pico 1.8°

Tempo após estabilizar (s)
