rickelmedias/1-DOF-Copter-Control/report/images/results/filtro_partida.pdf

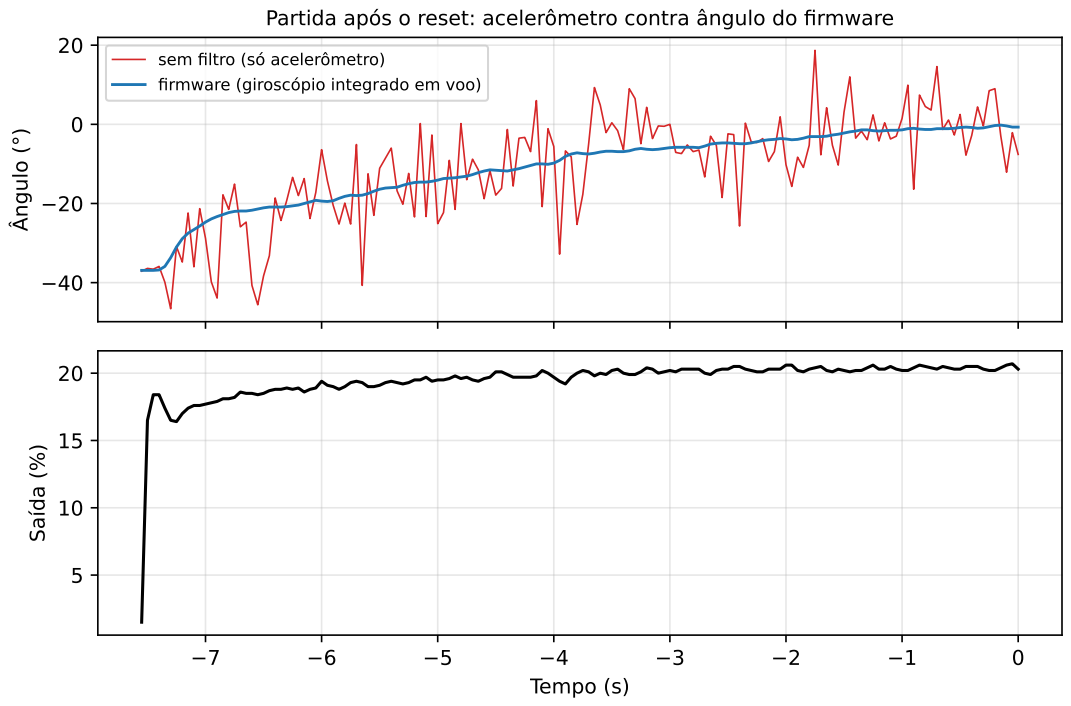
[picture p26: page 1]
Ângulo (°); Tempo (s); Saída (%)

Partida após o reset: acelerômetro contra ângulo do firmware

sem filtro (só acelerômetro)
firmware (giroscópio integrado em voo)
