rickelmedias/1-DOF-Copter-Control/report/images/results/refino_curvas.pdf

0.5

1.0

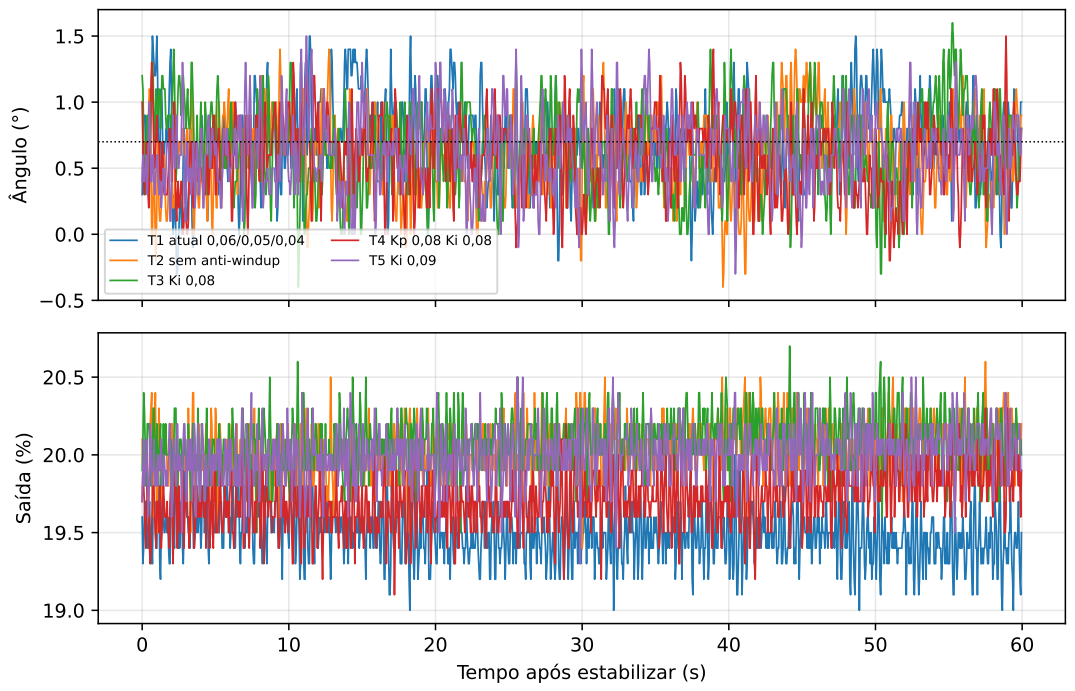
[picture p27: page 1]
Ângulo (°); Saída (%)

T1 atual 0,06/0,05/0,04
T2 sem anti-windup

Tempo após estabilizar (s)
