rickelmedias/1-DOF-Copter-Control/report/images/results/refino_degraus.pdf

−5

0

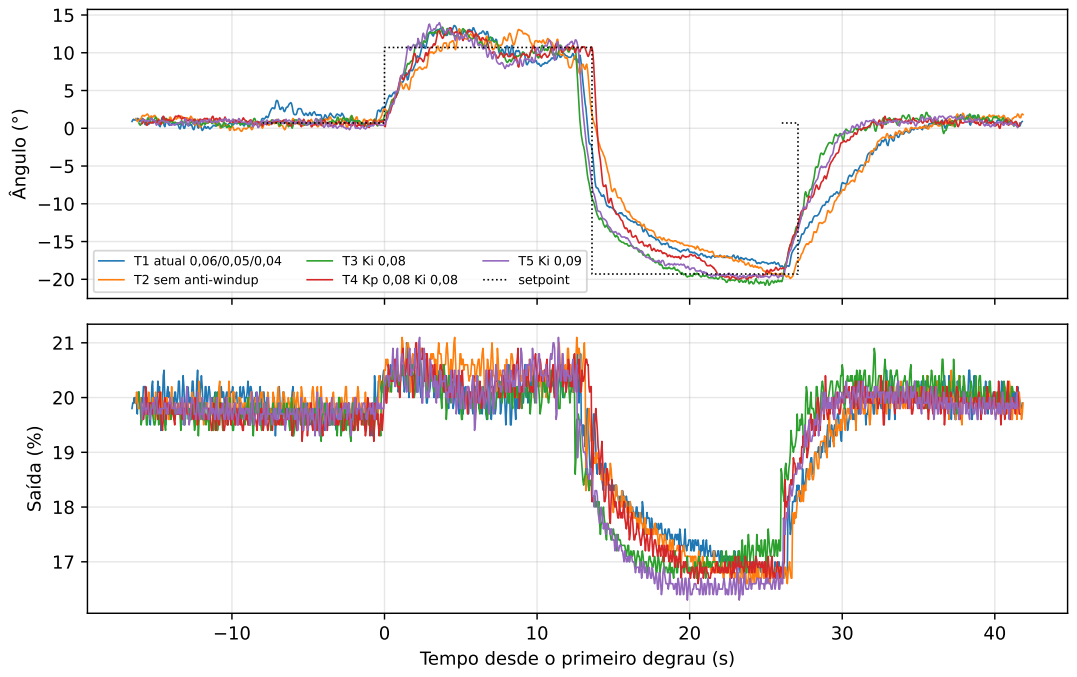
[picture p28: page 1]
Ângulo (°); T5 Ki 0,09 setpoint; Saída (%)

T1 atual 0,06/0,05/0,04
T2 sem anti-windup

Tempo desde o primeiro degrau (s)
