rickelmedias/1-DOF-Copter-Control/report/images/results/windup_ganhos_finais.pdf

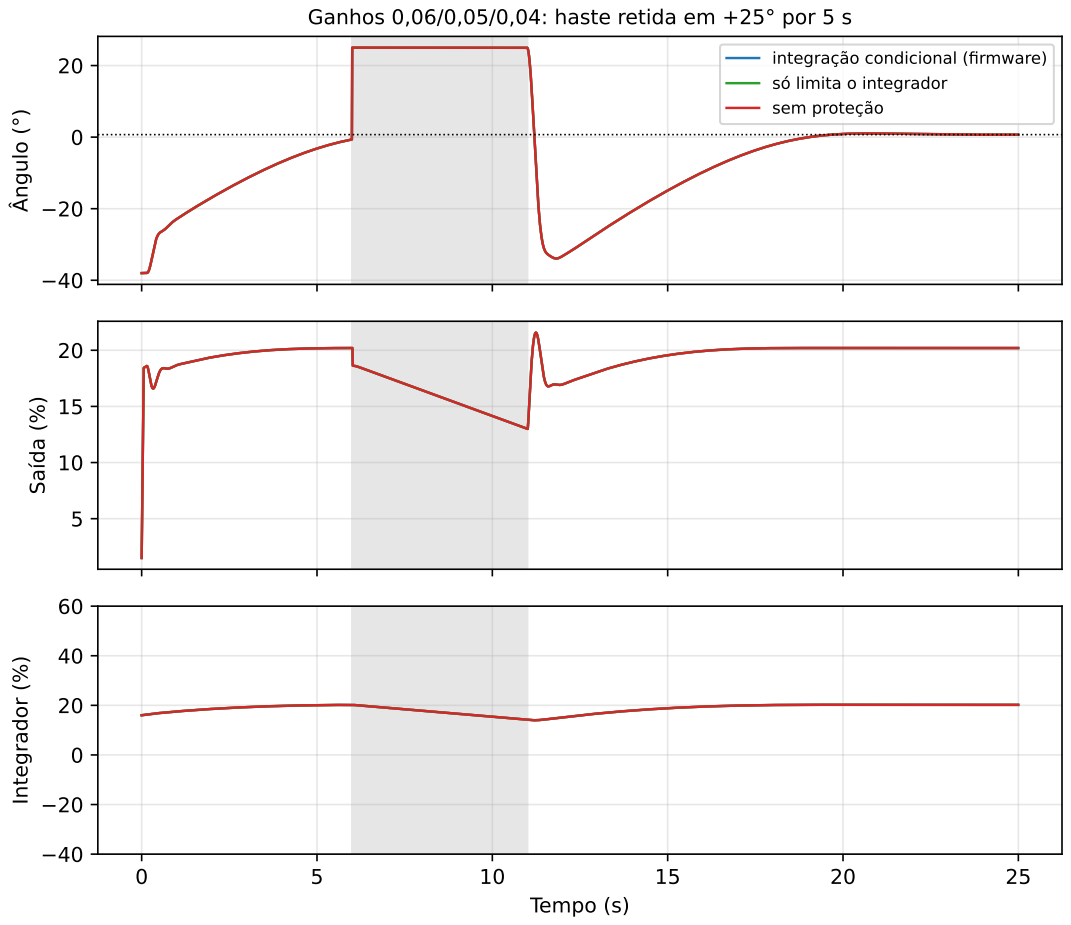
[picture p29: page 1]
Ângulo (°); Saída (%); Tempo (s); Integrador (%)

Ganhos 0,06/0,05/0,04: haste retida em +25° por 5 s

integração condicional (firmware)
só limita o integrador sem proteção
