rickelmedias/1-DOF-Copter-Control/report/images/results/windup_ganhos_iniciais.pdf

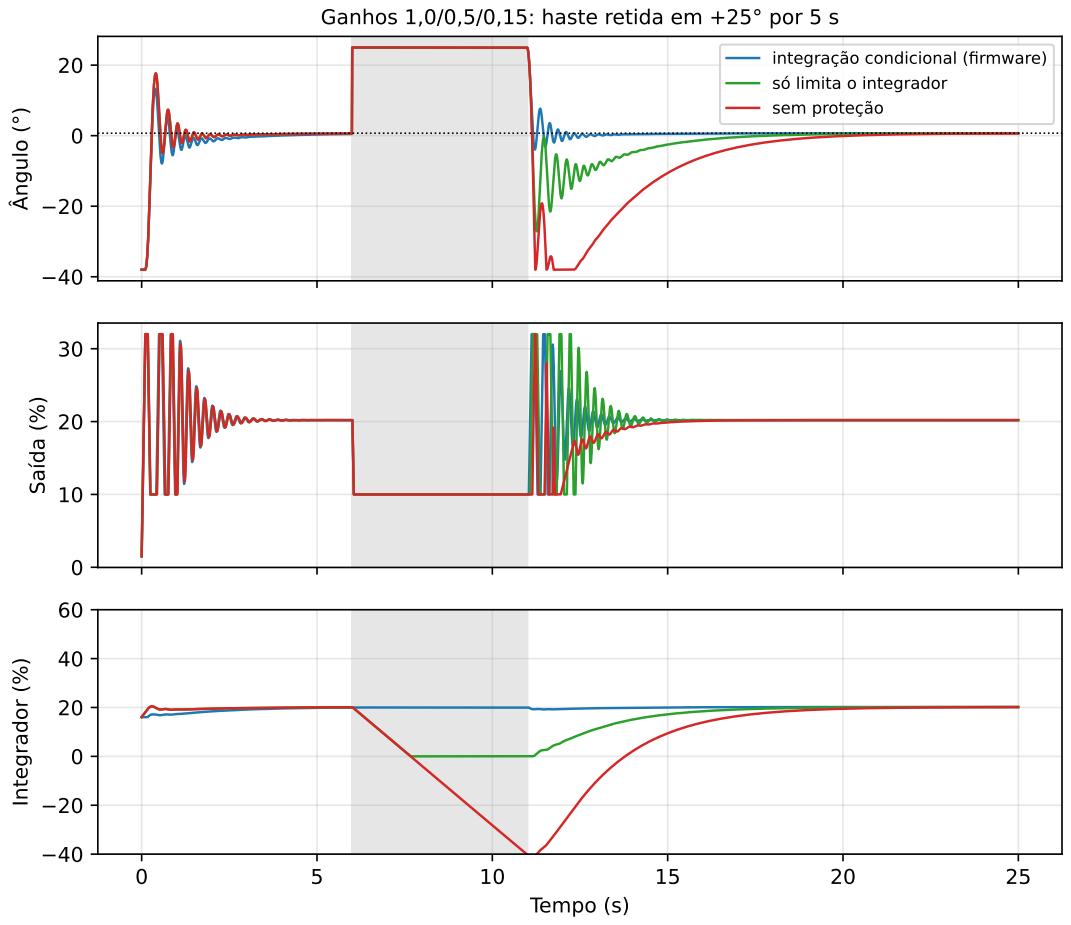
[picture p30: page 1]
Ângulo (°); Saída (%); Tempo (s); Integrador (%)

Ganhos 1,0/0,5/0,15: haste retida em +25° por 5 s

integração condicional (firmware)
só limita o integrador sem proteção
